dojoe/keyboardv2/hw/keyboardv2.kicad_pcb

## KiCad design hw/keyboardv2.kicad_pcb (2013-12-03)

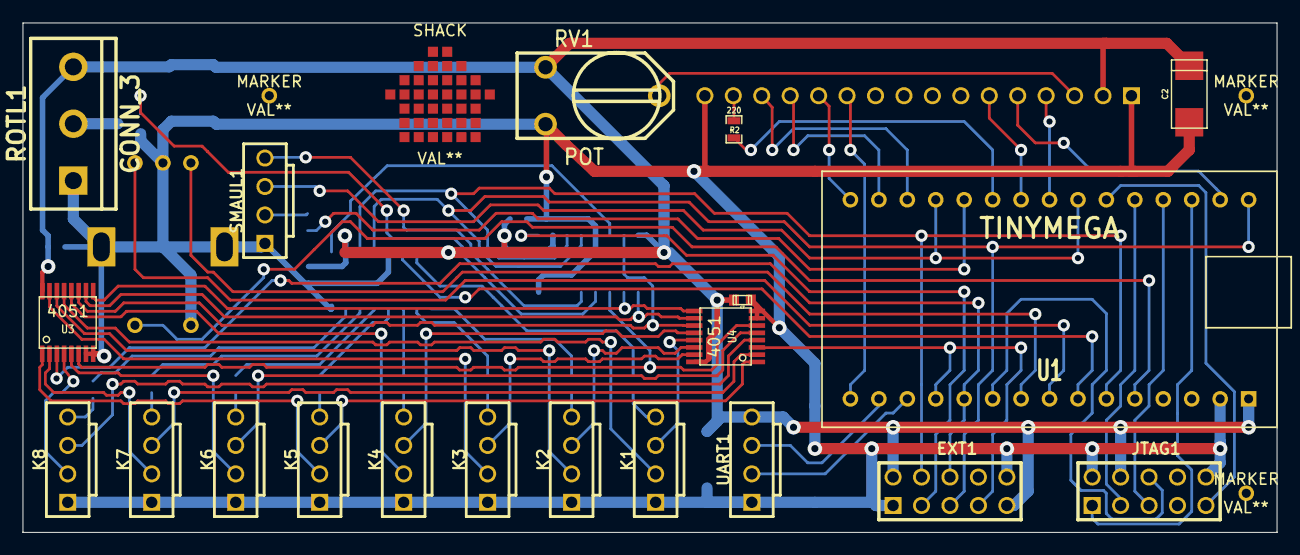
[picture p1: board keyboardv2.kicad_pcb from above]

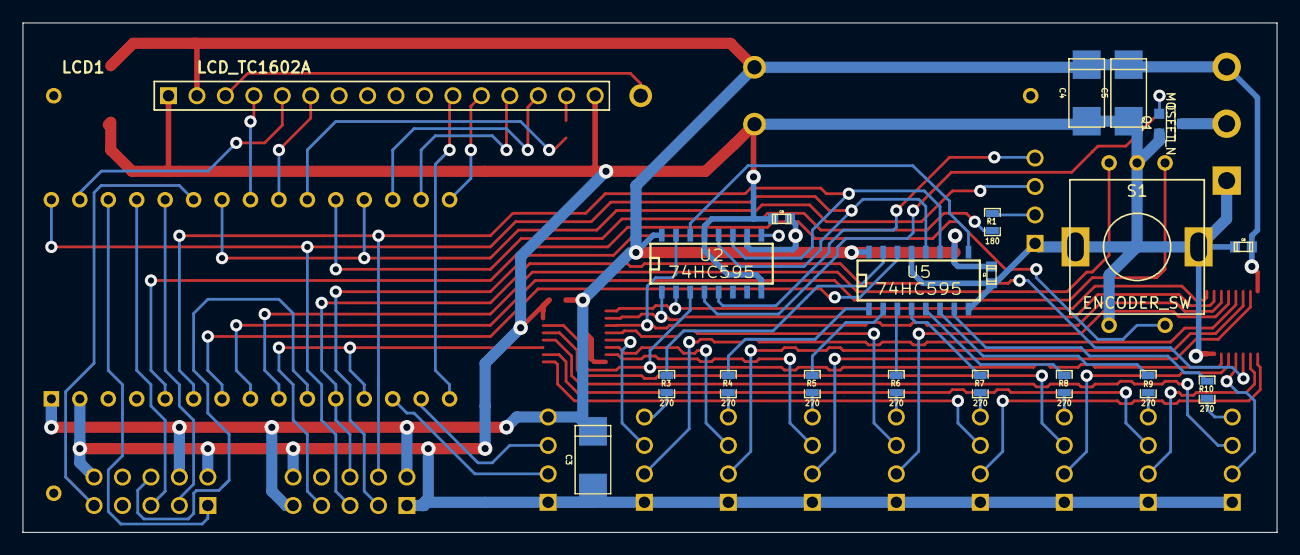
[picture p2: board keyboardv2.kicad_pcb from below]

Board: 2 copper layers, 112.0 x 45.5 mm, 44 parts (20 on the bottom side), 71 nets.

Parts:
C1, C6, C7, C8: 100n; c_0603
C2, C3, C4, C5: 10u; c_tant_C
EXT1: CONN_5X2; PIN_ARRAY_5x2_BPAD
JTAG1: CONN_5X2; PIN_ARRAY_5x2_BPAD
K1, K2, K3, K4, K5, K6, K7, K8: CONN_4; PIN_ARRAY_4x1_KEYED_BPAD
LCD1: LCD_TC1602A; pin_array_16x1_BPAD
MARKER: VAL**; MARKER
MARKER#2, MARKER#3: VAL**; MARKER
Q1: MOSFET_N; SOT23GDS
R1: 180; SM0603_Resistor
R2: 220; SM0603_Resistor
R3, R4, R5, R6, R7, R8, R9, R10: 270; SM0603_Resistor
ROTL1: CONN_3; bornier3
RV1: POT; RV2X4
S1: ENCODER_SW; Alps-EC11-Vert
SHACK: VAL**; SHACK
SMAUL1: CONN_4; PIN_ARRAY_4x1_KEYED_BPAD
U1: TINYMEGA; TinyMega
U2, U5: 74HC595; SO16E
U3, U4: 4051; tssop-16
UART1: CONN_4; PIN_ARRAY_4x1_KEYED_BPAD

Connections:
/!RESET: JTAG1.6, U1.10
/BLAULICHT: Q1.G, U2.4
/BLPWR: Q1.D, ROTL1.2
/BUZZER: SMAUL1.4, U2.5
/ENC_A: S1.2, U1.8
/ENC_B: S1.3, U1.9
/ENC_PUSH: S1.4, U1.5
/Key Jacks/!KEY_EN: U2.3, U3.6, U4.6
/Key Jacks/KEY_PWR: EXT1.6, U1.11, U3.3
/Key Jacks/KEY_SCIO: EXT1.7, U1.12, U4.3
/Key Jacks/KEY_SEL0: U2.15, U3.11, U4.11
/Key Jacks/KEY_SEL1: U2.1, U3.10, U4.10
/Key Jacks/KEY_SEL2: U2.2, U3.9, U4.9
/Key Jacks/LED_LATCH: EXT1.5, U1.30, U2.12, U5.12
/Key Jacks/LED_SCK: EXT1.4, U1.6, U2.11, U5.11
/Key Jacks/LED_SIN: U1.7, U5.14
/Key Jacks/LED_SOUT: U2.14, U5.9
/Key Jacks/led0: R3.2, U5.15
/Key Jacks/led1: R4.2, U5.1
/Key Jacks/led2: R5.2, U5.2
/Key Jacks/led3: R6.2, U5.3
/Key Jacks/led4: R7.2, U5.4
/Key Jacks/led5: R8.2, U5.5
/Key Jacks/led6: R9.2, U5.6
/Key Jacks/led7: R10.2, U5.7
/Key Jacks/pwr0: K1.2, U3.13
/Key Jacks/pwr1: K2.2, U3.14
/Key Jacks/pwr2: K3.2, U3.15
/Key Jacks/pwr3: K4.2, U3.12
/Key Jacks/pwr4: K5.2, U3.1
/Key Jacks/pwr5: K6.2, U3.5
/Key Jacks/pwr6: K7.2, U3.2
/Key Jacks/pwr7: K8.2, U3.4
/Key Jacks/scio0: K1.3, U4.13
/Key Jacks/scio1: K2.3, U4.14
/Key Jacks/scio2: K3.3, U4.15
/Key Jacks/scio3: K4.3, U4.12
/Key Jacks/scio4: K5.3, U4.1
/Key Jacks/scio5: K6.3, U4.5
/Key Jacks/scio6: K7.3, U4.2
/Key Jacks/scio7: K8.3, U4.4
/LCD_D0: LCD1.11, U1.15
/LCD_D1: LCD1.12, U1.16
/LCD_D2: LCD1.13, U1.17
/LCD_D3: LCD1.14, U1.18
/LCD_E: LCD1.6, U1.22
/LCD_LED: R2.2, U1.21
/LCD_RS: LCD1.4, U1.23
/LCD_RW: LCD1.5, U1.29
/M_RX: U1.13, UART1.2
/M_TX: U1.14, UART1.3
/SMAUL_BTN: SMAUL1.3, U1.19, U1.24
/SMAUL_LED: R1.1, U1.20
/SOUT: EXT1.3, U2.9
/TCK: JTAG1.1, U1.28
/TDI: JTAG1.9, U1.25
/TDO: JTAG1.3, U1.26
/TMS: JTAG1.5, U1.27
GND: C1.2, C2.2, C3.2, C4.2, C5.2, C6.2, C7.2, C8.2, EXT1.1, EXT1.10, JTAG1.2, JTAG1.10, K1.1, K2.1, K3.1, K4.1, K5.1, K6.1, K7.1, K8.1, LCD1.1, LCD1.16, Q1.S, ROTL1.1, RV1.3, S1.1, S1.5, S1.6, SMAUL1.1, U1.2, U2.8, U2.13, U3.7, U3.8, U4.7, U4.8, U5.8, U5.13, UART1.1
unnamed: LCD1.15, R2.1
unnamed: LCD1.3, RV1.2
unnamed: R1.2, SMAUL1.2
unnamed: K8.4, R10.1
unnamed: K1.4, R3.1
unnamed: K2.4, R4.1
unnamed: K3.4, R5.1
unnamed: K4.4, R6.1
unnamed: K5.4, R7.1
unnamed: K6.4, R8.1
unnamed: K7.4, R9.1
VCC: C1.1, C2.1, C3.1, C4.1, C5.1, C6.1, C7.1, C8.1, EXT1.2, EXT1.9, JTAG1.4, LCD1.2, ROTL1.3, RV1.1, U1.1, U2.10, U2.16, U3.16, U4.16, U5.10, U5.16, UART1.4
