dojoe/keyboardv2/(commit log)

2013-11-01 Add LCD driver (courtesy of danni) and still-haxxy rotary decoder
2013-11-03 Add hardware schematics
    [keyboardv2.sch, keyjacks.sch]
2013-11-03 Move input polling to timer interrupt
2013-11-13 Add decaps, make schematic fit for PCB, start PCB
    [keyboardv2.kicad_pcb, keyboardv2.sch, keyjacks.sch]
2013-11-16 Change LED pin order, complete routing of key jacks
    [keyboardv2.kicad_pcb, keyboardv2.sch, keyjacks.sch]
2013-11-16 Routed all signals, only VDD/GND remaining
    [keyboardv2.kicad_pcb, keyboardv2.sch, keyjacks.sch]
2013-11-16 All connections routed! \o/
    [keyboardv2.kicad_pcb, keyboardv2.sch]
2013-11-17 Yeah, so I had the board reversed -.- Once more with feeling.
    [keyboardv2.kicad_pcb, keyboardv2.sch, keyjacks.sch]
2013-11-17 Board complete. Again.
    [keyboardv2.kicad_pcb]
2013-12-03 Assign LED resistor values, change some labels for readability
    [keyboardv2.kicad_pcb, keyboardv2.sch, keyjacks.sch]
2013-12-03 Started bringup; some inputs, LCD, PWM LEDs and shift regs working
2014-01-12 Extract panel functions into own module, switch to latest LUFA
2014-01-24 Implement beeper driver
2014-01-26 LCD backlight, Smaul LED, key LEDs
2014-02-08 Genericize events, add timer event, add key management state machine
2014-02-09 Fix sporadic onewire failures due to irregular interrupt timing causing onewire clock jitter
    [panel.c]
2014-03-15 added tests for button up
2014-03-15 unified tests for encoder in menu, added start of a test that checks if the menu can perform an action and then shuts down
2014-03-15 added test for menu timer, code doesn't work yet
    [menu.c]
2014-03-15 wenn man tasten drückt, refreshed sich der menu timer
2014-03-15 beeps when timer runs out.
2014-03-15 rename schluesseltimer --> keytimer - for more english inside the repo - and i failed.
    [key_timer.c, key_timer.h]
2014-03-15 smaul will mute the first timer and reset it to 5 minutes.
    [key_timer.c, menu.c]
2014-03-15 pizza timer can be stopped using the menu
2014-03-15 prints --- when timer is inactive
2014-03-16 smaul button will pulse when keys / timers are overdue
2014-03-16 missing keys are detected and trigger alerts
    [key_timer.c, key_timer.h, ui.c]
2014-03-29 timer selection ui does not turnarount to 99 minutes when going to a number smaller than 1 minute
2014-03-29 Coding style fixes, refactoring and fixes around key timer
    [common.h, key.c, key_timer.c, key_timer.h, ui.c]
2014-03-29 Only start handling key change events when all key slots have a known state
2014-03-29 Fix key missing message being updated too often
    [panel.c, ui.c]
2014-03-29 Various fixes, ohai and obai messages
    [key_timer.c, ui.c, ui.h]
2014-03-30 Refactor piza timer handling, fix several UI bugs related to key insertion and removal
    [hw.h, key_timer.c, key_timer.h, ui.c, ui.h]
2014-03-30 Add key error handling, move error state management into UI code
    [key_timer.c, key_timer.h, ui.c, ui.h]
2014-03-30 Pulse Smaul button LED while keys are missing
    [key_timer.c, key_timer.h, panel.c, ui.c]
2014-03-30 Overengineer Smaul LED pulsing, separate from UI repainting
2014-03-31 Start Smaul LED effects in defined state
2014-03-31 Some timer related fixes
    [key_timer.c, key_timer.h, ui.c]
2014-03-31 Use sign checks for timers
2014-04-02 On key alarm, sync smaul LED to beeper
2014-04-02 List missing keys during idle
    [ui.c]
2014-04-02 Make sure smaul pulsing is not reset during UI state changes
    [ui.c]
2014-04-03 Serial: Add reminder to reset after config change, add reset command
    [cmd.c, common.c, common.h, config.c, config.h]
2014-04-17 Make shiftreg value updates atomic, properly abort SPI transmission when restarting (possibly fixes issue #1)
    [key.c, panel.c]
2014-07-21 Add test mode to manually enable/power/scan individual slots
